alexanderjg85/simple_msp430_g2_pdip20_devboard/Hardware/MSP430_G2_PDIP20_Devboard_THT/Documents/MSP430_G2_PDIP20_Devboard_THT.pdf

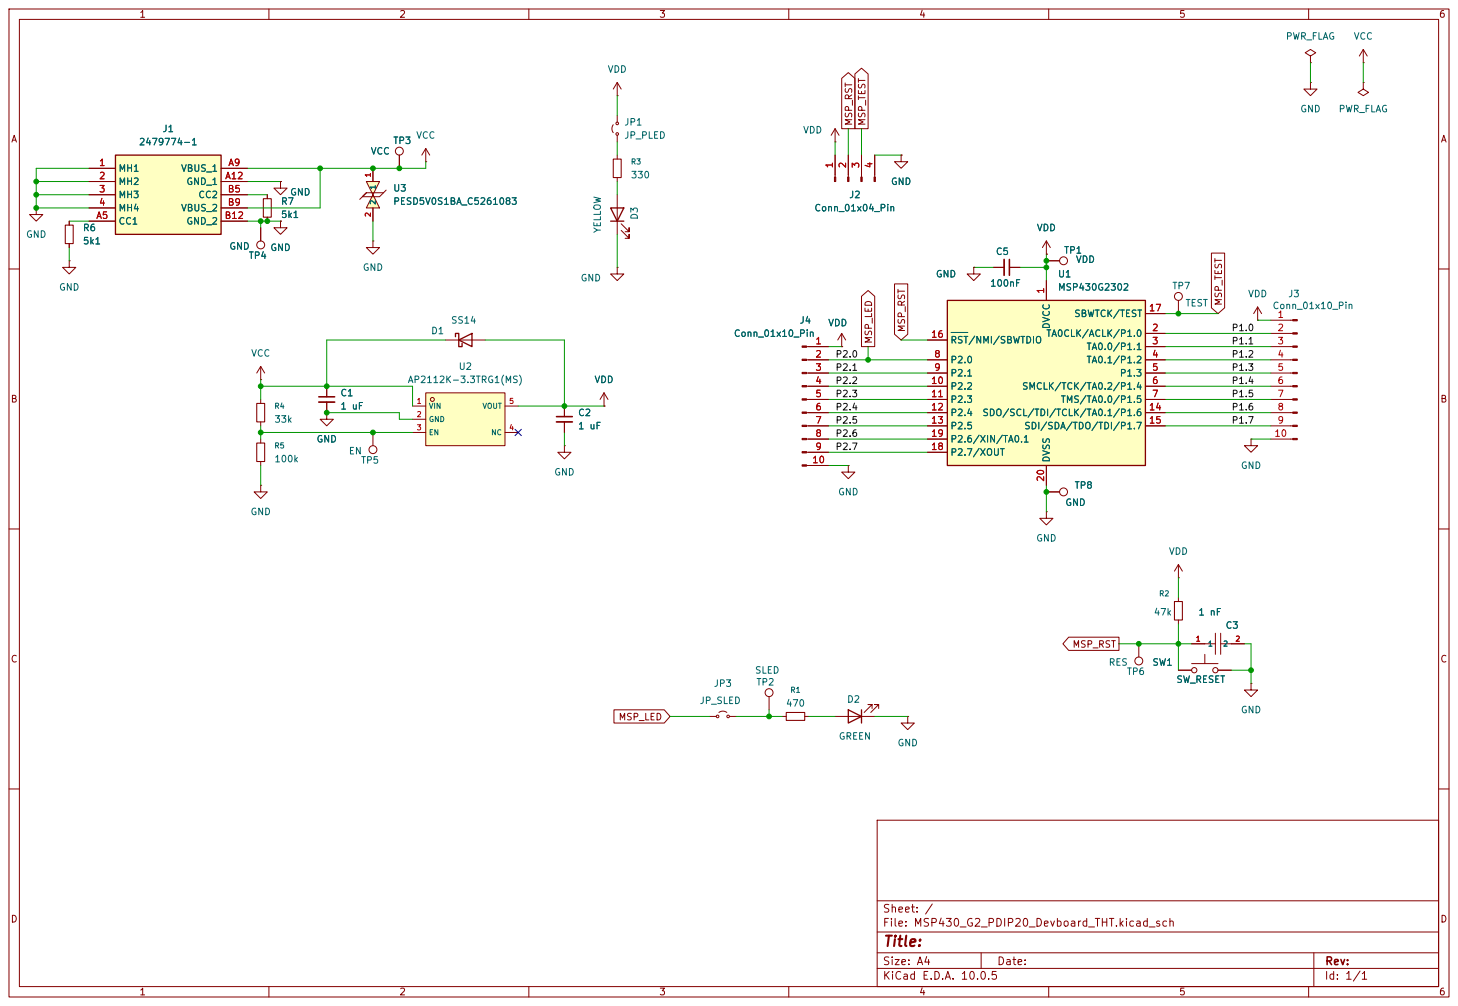
[picture p1: page 1]

Size: A4 | Rev:
KiCad E.D.A. 10.0.5 | Id: 1/1
