alexanderjg85/simple_msp430_g2_pdip20_devboard/Hardware/MSP430_G2_PDIP20_Devboard_THT/Documents/MSP430_G2_PDIP20_Devboard_THT_layout_top.pdf

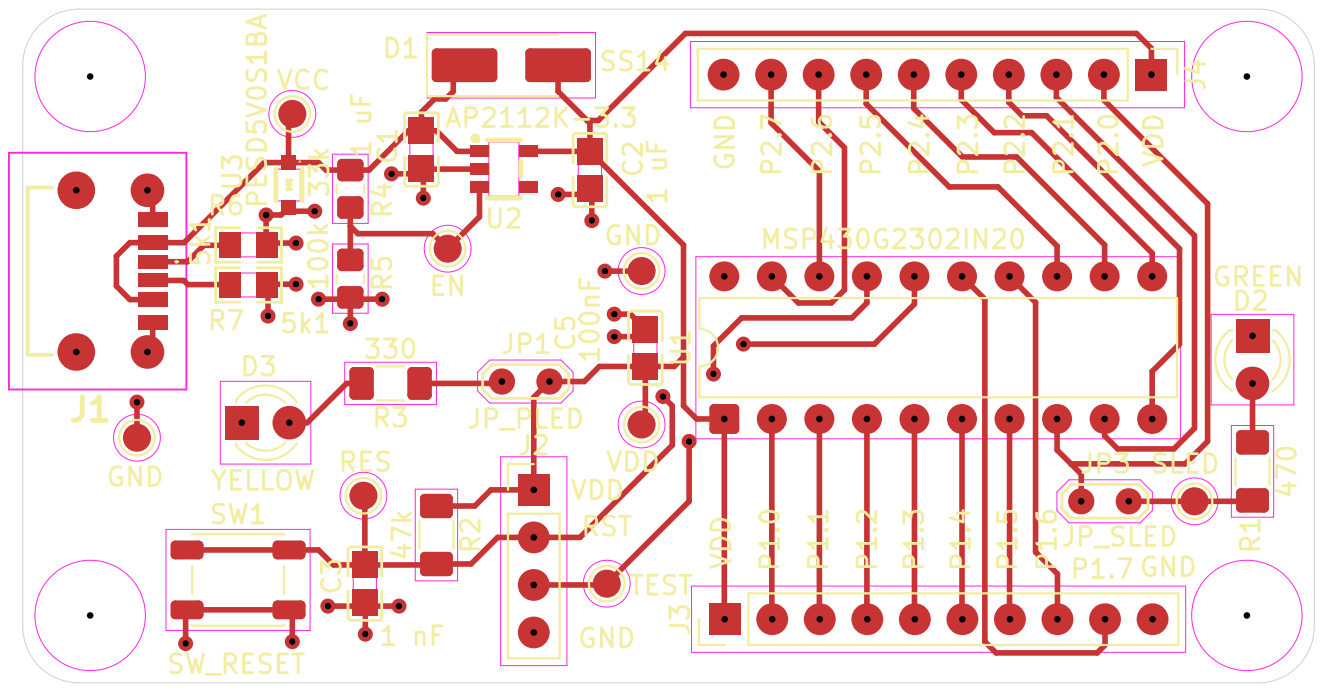
[picture p3: page 1]
