alexanderjg85/simple_msp430_g2_pdip20_devboard/Hardware/MSP430_G2_PDIP20_Devboard_THT/MSP430_G2_PDIP20_Devboard_THT.kicad_pcb

## KiCad design Hardware/MSP430_G2_PDIP20_Devboard_THT/MSP430_G2_PDIP20_Devboard_THT.kicad_pcb (2026-09-28)

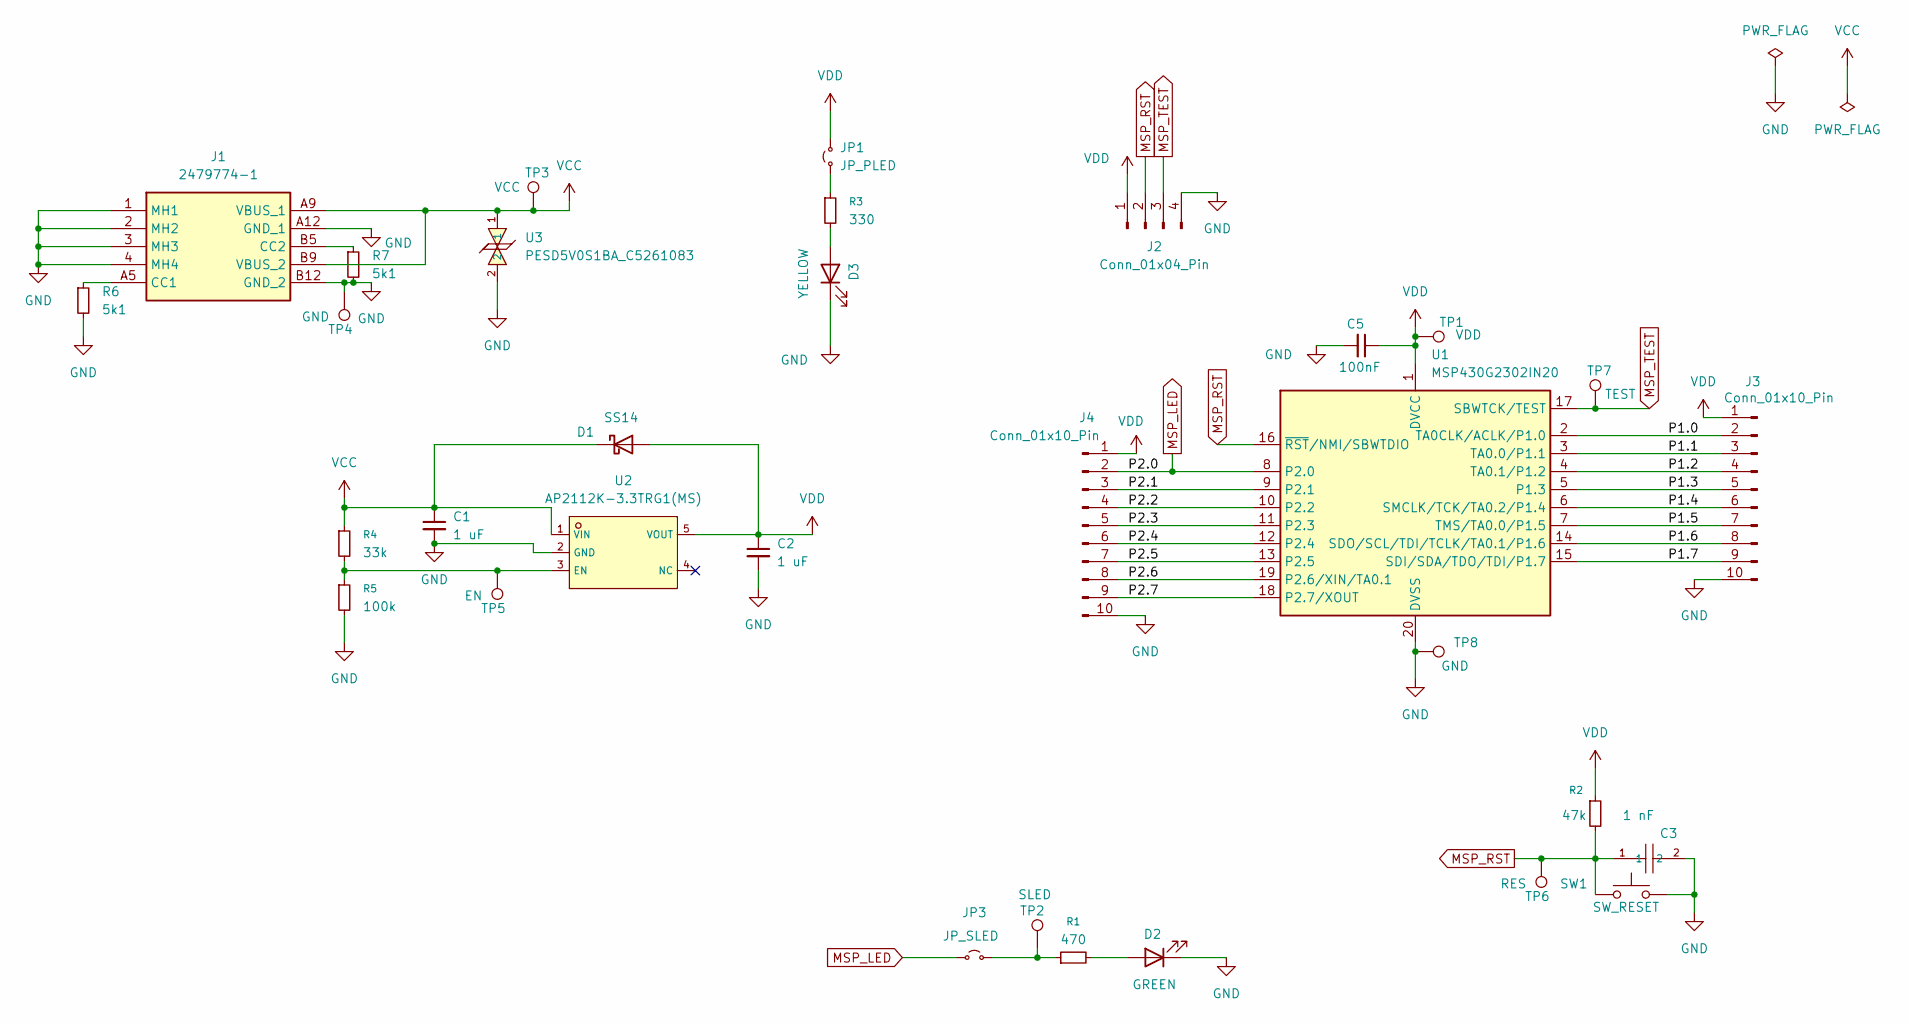
[picture p4: schematic MSP430_G2_PDIP20_Devboard_THT.kicad_sch]

Parts:
C1, C2: 1 uF; C6119929_C0805; LCSC C6119929
C3: 1 nF; C141155_C0805; LCSC C141155
C5: 100nF; C49678_C0805; LCSC C49678
D1: SS14; D_SMA_Handsoldering; LCSC C2480
D2: GREEN; LED_D3.0mm
D3: YELLOW; LED_D3.0mm
J1: 2479774-1; 24797741; Mouser Part Number 571-2479774-1
J2: Conn_01x04_Pin; PinHeader_1x04_P2.54mm_Vertical
J3, J4: Conn_01x10_Pin; PinHeader_1x10_P2.54mm_Vertical
JP1: JP_PLED; TestPoint_2Pads_Pitch2.54mm_Drill0.8mm
JP3: JP_SLED; TestPoint_2Pads_Pitch2.54mm_Drill0.8mm
R1: 470; R_1206_3216Metric_Pad1.30x1.75mm_HandSolder
R2: 47k; R_1206_3216Metric_Pad1.30x1.75mm_HandSolder
R3: 330; R_1206_3216Metric_Pad1.30x1.75mm_HandSolder
R4: 33k; R_0805_2012Metric_Pad1.20x1.40mm_HandSolder
R5: 100k; R_0805_2012Metric_Pad1.20x1.40mm_HandSolder; LCSC C17407
R6, R7: 5k1; C2907269_R0805; LCSC C2907269
SW1: SW_RESET; SW_SPST_PTS647_Sx38_Handsolder; MFR PN SWT0210-045026GSA
TP1: VDD; TestPoint_Pad_D1.5mm
TP2: SLED; TestPoint_Pad_D1.5mm
TP3: VCC; TestPoint_Pad_D1.5mm
TP4, TP8: GND; TestPoint_Pad_D1.5mm
TP5: EN; TestPoint_Pad_D1.5mm
TP6: RES; TestPoint_Pad_D1.5mm
TP7: TEST; TestPoint_Pad_D1.5mm
U1: MSP430G2302IN20; DIP-20_W7.62mm
U2: AP2112K-3.3TRG1(MS); C22365427_SOT-23-5_L2_9-W1_6-P0_95-LS2_7-BR; LCSC C22365427
U3: PESD5V0S1BA_C5261083; C5261083_SOD-323_L1_7-W1_3-LS2_5-BI; LCSC C5261083

Connections:
/P1.0: J3.2, U1.2 (TA0CLK/ACLK/P1.0)
/P1.1: J3.3, U1.3 (TA0.0/P1.1)
/P1.2: J3.4, U1.4 (TA0.1/P1.2)
/P1.3: J3.5, U1.5 (P1.3)
/P1.4: J3.6, U1.6 (SMCLK/TCK/TA0.2/P1.4)
/P1.5: J3.7, U1.7 (TMS/TA0.0/P1.5)
/P1.6: J3.8, U1.14 (SDO/SCL/TDI/TCLK/TA0.1/P1.6)
/P1.7: J3.9, U1.15 (SDI/SDA/TDO/TDI/P1.7)
/P2.1: J4.3, U1.9 (P2.1)
/P2.2: J4.4, U1.10 (P2.2)
/P2.3: J4.5, U1.11 (P2.3)
/P2.4: J4.6, U1.12 (P2.4)
/P2.5: J4.7, U1.13 (P2.5)
/P2.6: J4.8, U1.19 (P2.6/XIN/TA0.1)
/P2.7: J4.9, U1.18 (P2.7/XOUT)
GND: C1.2, C2.2, C3.2, C5.2, D2.1 (K), D3.1 (K), J1.1 (MH1), J1.2 (MH2), J1.3 (MH3), J1.4 (MH4), J1.A12 (GND_1), J1.B12 (GND_2), J2.4, J3.10, J4.10, R5.2, R6.2, R7.2, SW1.2, TP4.1 (1_1), TP8.1 (1_1), U1.20 (DVSS), U2.2 (GND), U3.2
MSP_LED: J4.2, JP3.1 (A), U1.8 (P2.0)
MSP_RST: C3.1, J2.2, R2.2, SW1.1, TP6.1 (1_1), U1.16 (~RST/NMI/SBWTDIO)
MSP_TEST: J2.3, TP7.1 (1_1), U1.17 (SBWTCK/TEST)
unnamed: D2.2 (A), R1.2
unnamed: D3.2 (A), R3.2
unnamed: J1.A5 (CC1), R6.1
unnamed: J1.B5 (CC2), R7.1
unnamed: JP1.1 (A), R3.1
unnamed: JP3.2 (B), R1.1, TP2.1 (1_1)
unnamed: R4.2, R5.1, TP5.1 (1_1), U2.3 (EN)
VCC: C1.1, D1.1 (K), J1.A9 (VBUS_1), J1.B9 (VBUS_2), R4.1, TP3.1 (1_1), U2.1 (VIN), U3.1
VDD: C2.1, C5.1, D1.2 (A), J2.1, J3.1, J4.1, JP1.2 (B), R2.1, TP1.1 (1_1), U1.1 (DVCC), U2.5 (VOUT)

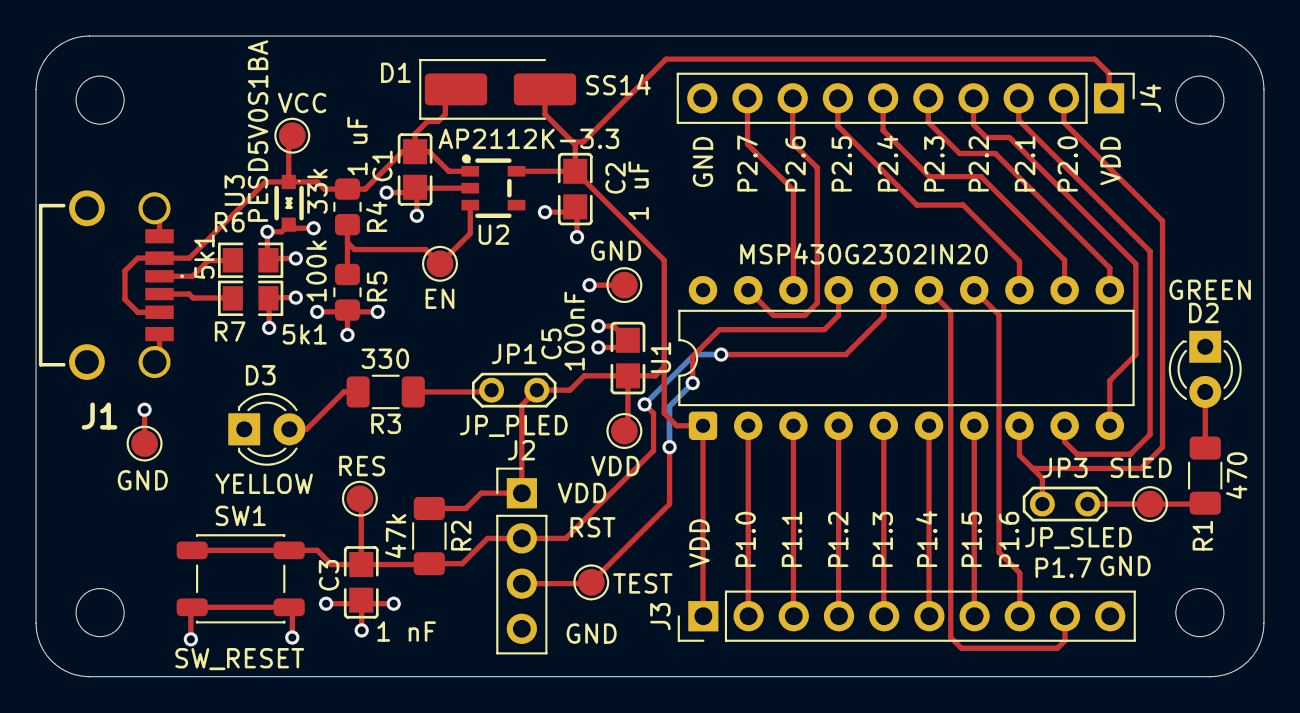
[picture p5: board MSP430_G2_PDIP20_Devboard_THT.kicad_pcb from above]

Board: 2 copper layers, 69.0 x 36.0 mm, 32 parts (0 on the bottom side), 28 nets.
