alexanderjg85/simple_msp430_g2_pdip20_devboard/(commit log)

2026-09-09 Added Kicad Project files for MSP430 G2 G2 PDIP20 Dev Board
    [MSP430_G2_PDIP20_Devboard_THT.kicad_pcb, MSP430_G2_PDIP20_Devboard_THT.kicad_sch]
2026-09-17 MSP430 G2 PDIP20 Dev Board - Schematics - Placed Components
    [MSP430_G2_PDIP20_Devboard_THT.kicad_sch]
2026-09-18 MSP430 G2 PDIP20 Dev Board - Schematics - Wired Power related signals and components
    [MSP430_G2_PDIP20_Devboard_THT.kicad_sch]
2026-09-20 MSP430 G2 PDIP20 Dev Board - Schematics - Wirring finsished
    [MSP430_G2_PDIP20_Devboard_THT.kicad_sch]
2026-09-21 MSP430 G2 PDIP20 Dev Board - Schematics - Added Testpoints
    [MSP430_G2_PDIP20_Devboard_THT.kicad_sch]
2026-09-21 MSP430 G2 PDIP20 Dev Board - Schematics - Assigned Footprint to Pinheader J4
    [MSP430_G2_PDIP20_Devboard_THT.kicad_sch]
2026-09-26 MSP430 G2 PDIP20 Dev Board - Added datasheets
2026-09-26 MSP430 G2 PDIP20 Dev Board - Layout - Initial Placement done
    [MSP430_G2_PDIP20_Devboard_THT.kicad_pcb]
2026-09-26 MSP430 G2 PDIP20 Dev Board - Layout - Added JLCPCB Design Rules
    [MSP430_G2_PDIP20_Devboard_THT.kicad_pcb]
2026-09-27 MSP430 G2 PDIP20 Dev Board - Layout - Initial Routing done
    [MSP430_G2_PDIP20_Devboard_THT.kicad_pcb]
2026-09-27 MSP430 G2 PDIP20 Dev Board - Layout - Added Mounting Holes
    [MSP430_G2_PDIP20_Devboard_THT.kicad_pcb]
2026-09-28 MSP430 G2 PDIP20 Dev Board - Layout - Finished Silk Screen
    [MSP430_G2_PDIP20_Devboard_THT.kicad_pcb]
2026-09-28 MSP430 G2 PDIP20 Dev Board - Layout - Added Gerber Files
    [MSP430_G2_PDIP20_Devboard_THT-B_Cu.gbr, MSP430_G2_PDIP20_Devboard_THT-B_Mask.gbr, MSP430_G2_PDIP20_Devboard_THT-B_Paste.gbr, MSP430_G2_PDIP20_Devboard_THT-B_Silkscreen.gbr, MSP430_G2_PDIP20_Devboard_THT-Edge_Cuts.gbr, MSP430_G2_PDIP20_Devboard_THT-F_Cu.gbr, MSP430_G2_PDIP20_Devboard_THT-F_Mask.gbr, MSP430_G2_PDIP20_Devboard_THT-F_Paste.gbr]
2026-10-04 MSP430 G2 PDIP20 Dev Board - Layout - Added Board statistics
2026-10-04 MSP430 G2 PDIP20 Dev Board - Added BOM
    [MSP430_G2_PDIP20_Devboard_THT.kicad_sch, MSP430_G2_PDIP20_Devboard_THT_BOM.tsv]
2026-10-12 MSP430 G2 PDIP20 Dev Board - Added Schematic and Board Layout PDFs
